K2AAM/HF-Receive-Multicoupler-/hardware/kicad/enclosure_report.txt

HAMMOND 1590C FIT - build A prototype (generated by enclosure.py)
Box frame: origin = centre of the four cover-screw holes; +y = front (output) wall; +x = U1 side; z = above INSIDE floor;
z_out = z + 2.25 = above the OUTSIDE bottom face.

1. Enclosure data and sources
   [MFR   ] outside length (at rim): 119.5
   [MFR   ] outside width (at rim): 94.0
   [MFR   ] body height without lid: 52.5
   [MFR   ] lid thickness: 4.0
   [MFR   ] overall height with lid: 56.5
   [MFR   ] floor thickness: 2.25
   [MFR   ] inside height, floor to underside of lid: 52.25  (lid pocket 2.00 deep (MFR))
   [CALC  ] inside floor to rim: 50.25
   [DWG   ] inside floor to bottom of lid lip: 48.25  (lid lip projects 2.0 below the rim, 0.57 mm inside the wall)
   [MFR   ] inside length at rim: 115.14
   [MFR   ] inside width at rim: 89.64
   [MFR   ] inside length near floor: 111.27  (DWG: measured 0.96 mm above the floor, at the top of the R1.0 floor fillet)
   [MFR   ] inside width near floor: 85.77
   [DWG   ] height of the near-floor inside dimensions: 0.96
   [DWG   ] inside floor fillet radius: 1.0
   [DWG   ] wall thickness (horizontal): 2.18  (outer wall drafted parallel to inner; 2.18 at the rim)
   [CALC  ] wall draft tan: 0.0393
   [MFR   ] cover-screw (6-32) pattern: (109.5, 84.0)  (screw centres (+-54.75, +-42.00): use as the drilling datum)
   [DWG   ] screw-pillar arc centre: (54.82, 42.07)
   [DWG   ] screw-pillar radius, worst (near floor): 5.94  (arcs R4.94 and R5.94 about the pillar centre; 103.64 x 78.14 between pillar faces at the rim (MFR))
   [CALC  ] draft: 2.25 deg per side

2. Stack-up (z above inside floor)
   M3 x 6 mm brass spacers -> PCB 6.0-7.6; BNC centreline 16.2; lid lip bottom 48.25; rim 50.25; lid pocket 52.25
   C1    top  26.7  ->  21.5 mm below the lid lip,  25.5 below the lid pocket (KEMET R60EI4470AA30J H 19.1)
   J5    top  24.0  ->  24.2 mm below the lid lip,  28.2 below the lid pocket (031-5431-10RFX CL 8.6 + 15.6/2)
   J2    top  24.0  ->  24.2 mm below the lid lip,  28.2 below the lid pocket (031-5431-10RFX CL 8.6 + 15.6/2)
   J4    top  24.0  ->  24.2 mm below the lid lip,  28.2 below the lid pocket (031-5431-10RFX CL 8.6 + 15.6/2)
   J3    top  24.0  ->  24.2 mm below the lid lip,  28.2 below the lid pocket (031-5431-10RFX CL 8.6 + 15.6/2)
   C22   top  20.6  ->  27.6 mm below the lid lip,  31.6 below the lid pocket (Panasonic FR 8x11.5 + 1.5)
   Solder side: 6.0 mm from PCB bottom to inside floor (clipped leads <= 1.5 mm -> >= 4.5 mm clear)

3. Board in the box
   Board 104 x 78, corner notches 7.0 x 7.0, outline unchanged. Board offset DY = +1.42 mm toward the front wall (set by the BNC faces).
   Side clearance at PCB bottom: x 3.83 each side; front edge 2.67; back edge 5.50
   screw pillar at (-54.82,-42.07) R5.94: clearance to notched board edge 4.86 mm
   screw pillar at (-54.82,+42.07) R5.94: clearance to notched board edge 3.16 mm
   screw pillar at (+54.82,-42.07) R5.94: clearance to notched board edge 4.86 mm
   screw pillar at (+54.82,+42.07) R5.94: clearance to notched board edge 3.16 mm
   Without the notches the board corner would be inside the pillars -> keep the notched outline.

4. Output BNCs (031-5431-10RFX, rear mount) on the drafted front wall
   The wall leans out 2.25 deg; across the 15.6 mm housing face that is 0.61 mm, so the face cannot seat flat on the as-cast wall.
   Inside: mill one flat strip 82 long x 22 high centred on the BNC row, plane perpendicular to the floor at y = 43.915
   (cut 0 at its top edge, 0.86 at its bottom edge). Separate dia 22 spot-faces would overlap at the 20 mm pitch.
   Outside: parallel strip 80 x 20 at y = 45.271 (cut 0.79 at its top edge, 0 at its bottom).
   Finished wall at each BNC: 1.36 mm (connector limit 5.0 max).
   BNC front face lands on the inside spot-face at board offset DY = +1.415: zero gap by construction; floor holes dia 4.2
   give +-0.6 mm float so the BNC nuts, not the spacers, position the board (tighten spacer screws last).

5. Insertion path of the board with its four BNCs (2D search over tilt and travel along the BNC axis)
   Back edge to back wall when level: 5.50 mm, but the 1/2-28 thread is 8.9 mm long,
   so the board cannot be slid in level: it has to go in tilted, which needs a front hole larger than the thread.
   opening 12.83 high: no path - the board cannot be fitted
   opening 14.00 high: no path - the board cannot be fitted
   opening 14.40 high: PATH FOUND (barrels fully withdrawn at a tilt of 29.5 deg, BNC end down)
   opening 15.50 high: PATH FOUND (barrels fully withdrawn at a tilt of 29.5 deg, BNC end down)
   Path found: back the board off level about 0.2 mm, then tilt the BNC end down while withdrawing;
   up to 31.0 deg while the thread is still in the slot, 31.0 deg once only the bayonet is (back end above the rim).
   Assembly is the same path in reverse (lid off).
   Chosen: vertical slot 12.9 wide x 15.5 high (obround, no D-flat; the soldered board stops the connectors turning).
   Amphenol's dia 12.83 D-hole is too tight for the tilt: with it the board cannot be fitted at all.
   Housing-face bearing on the inside spot-face: 62 mm2 (0.80 mm strips at the sides + corners).
   Outside: DIN 433 M12 flat washer (OD 20) + the supplied lock washer + nut; stack 4.4 mm of the 8.9 mm thread before the nut.
   Fit J1 and J6 (wired panel jacks) after the board: the tilting board sweeps through their volume.

6. Panel jacks
   J1 031-221-RFX, left wall: y = -8.0, z = 24.0 (z_out 26.25). Nut/body keep-out 15 deep, +-7.4:
      parts below: MH1; clearance below 7.0 mm, to lid lip 16.9 mm; wall 2.18 <= 3.2 max
   J6 Switchcraft 722A, back wall: x = +36.0, z = 26.0 (z_out 28.25). Body keep-out 16 deep, +-8 x +-6:
      parts below: C17, J6; clearance below 5.0 mm, to lid lip 16.2 mm; wall 2.18 <= 3.1 max
   Both are wired jacks, so the 2.25 deg wall draft only tilts the jack; no PCB load. Spot-face if a flat nut seat is wanted.

7. U1 (LM317T lying tab-down, tab = VOUT ~9.8 V)
   Tab/body x 30.3..51.2: 4.69 mm from the grounded right wall; top at z 12.6, 35.6 mm below the lid lip.
   No F.Cu copper under body/tab (keep-out on the PCB); tab rests on solder mask over bare laminate. Use a nylon M3 screw or none.

8. Screws and ground bond
   Spacers: Wurth 970060354, M3 x 6 brass female-female, 5 mm hex. Top: M3 x 5 pan + washer (2.9 mm engagement).
   Bottom: M3 x 5 pan + washer through dia 4.2 floor holes (2.25 mm engagement); 5.15 mm total < 6 mm spacer thread.
   Ground: spacer end faces bear on bare die-cast floor (natural 1590C; remove paint on a 1590CBK); BNC shells clamp to the
   bare spot-faces. MH1 sits 6.7 mm from the GDT ground pad.

9. Floor holes (box frame, from the cover-screw centre), dia 4.2: MH1 (-38.50, -10.58); MH2 (-46.50, +26.42); MH3 (+46.50, +26.42); MH4 (+47.50, -26.38); MH5 (-34.00, +11.42)
   Front-wall BNC slots: x = -30, -10, +10, +30; centre z = 16.20 (z_out 18.45); 12.9 wide x 15.5 high, axis parallel to the floor.
   Left-wall J1: y = -8.0, z_out 26.25; back-wall J6: x = +36.0, z_out 28.25.

RESULT OK (assumptions in section 1 and the ASSUME items in docs/pcb-prototype-A.md still need measuring)
