K2AAM/HF-Receive-Multicoupler-/hardware/kicad/drill_drawing_1590C.pdf

inside floor

20.00 | 20.00 | 20.00

30.00 from centre

Z_out 18.45

FRONT (OUTPUT) WALL - viewed from outside. 4 x SLOT 12.9 wide x 15.5 high (J2-J5, 031-5431-10RFX). 15.5

12.9

Mill flat, perpendicular to the slot axis: INSIDE strip 82 x 22 (blue dotted; cut 0 at its top edge -> 0.86 at its bottom) and OUTSIDE strip 80 x 20 (red dashed; 0 at its bottom -> 0.79 at its top). Finished wall between the strips 1.36 +-0.1. Slots: drill dia 12.9 at +-1.3 mm above/below centre and file to the obround.

DATUMS: X/Y = centre of the four 6-32 cover-screw holes (109.50 x 84.00 pattern, Hammond). Z_out = height above the OUTSIDE bottom face; the inside floor is at Z_out 2.25 (Hammond floor 2.25). Drill wall holes parallel to the floor
(2.25 deg off the drafted wall normal). Dimensions in mm. Verify on the actual box before drilling.

8.00 toward the back wall

Z_out 26.25

LEFT END WALL (input) - viewed from outside; front/output wall to the LEFT. J1 Amphenol 031-221-RFX.

D-hole dia 11.1 with flat 10.3 across (Amphenol panel type U) - confirm on the 031-221-RFX drawing. Connector inserted from outside; nut + lock washer inside.

DATUMS: X/Y = centre of the four 6-32 cover-screw holes (109.50 x 84.00 pattern, Hammond). Z_out = height above the OUTSIDE bottom face; the inside floor is at Z_out 2.25 (Hammond floor 2.25). Drill wall holes parallel to the floor
(2.25 deg off the drafted wall normal). Dimensions in mm. Verify on the actual box before drilling.

36.00 toward the U1 / right end

Z_out 28.25

BACK WALL (DC input) - viewed from outside; the U1 end is on the RIGHT. J6 Switchcraft 722A.

D-hole dia 8.00 with flat 7.37 across (Switchcraft 5/16-32 bushing) - confirm on the 722A drawing.
Jack body inside, washer + nut outside; turn the solder lugs horizontal.

DATUMS: X/Y = centre of the four 6-32 cover-screw holes (109.50 x 84.00 pattern, Hammond). Z_out = height above the OUTSIDE bottom face; the inside floor is at Z_out 2.25 (Hammond floor 2.25). Drill wall holes parallel to the floor
(2.25 deg off the drafted wall normal). Dimensions in mm. Verify on the actual box before drilling.

MH1
(-38.50, -10.58)

MH2
(-46.50, +26.42)

MH3
(+46.50, +26.42)

MH4
(+47.50, -26.38)

MH5
(-34.00, +11.42)

FLOOR - viewed from INSIDE (output wall at the top). 5 x dia 4.2 for M3 spacer screws.

Coordinates (x, y) from the centre of the cover-screw pattern; + y toward the output wall, + x toward the U1 end.
When marking from the OUTSIDE (box upside down) the x values change sign. Dashed green = PCB outline.

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
