K2AAM/HF-Receive-Multicoupler-/hardware/kicad/erc_native.png

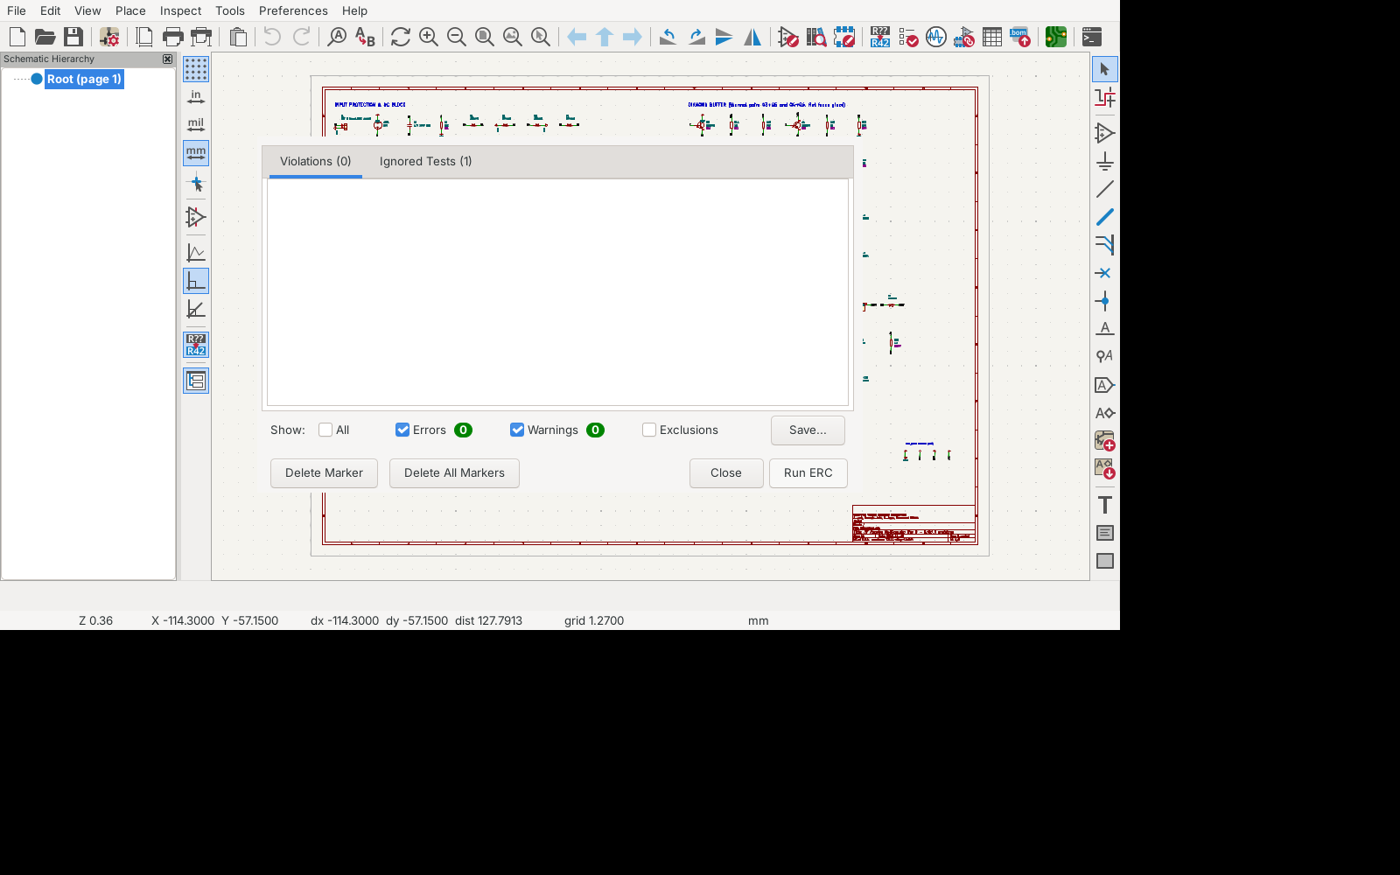
hardware/kicad/erc_native.png
