K2AAM/HF-Receive-Multicoupler-/hardware/kicad/img/drill_back_wall.png

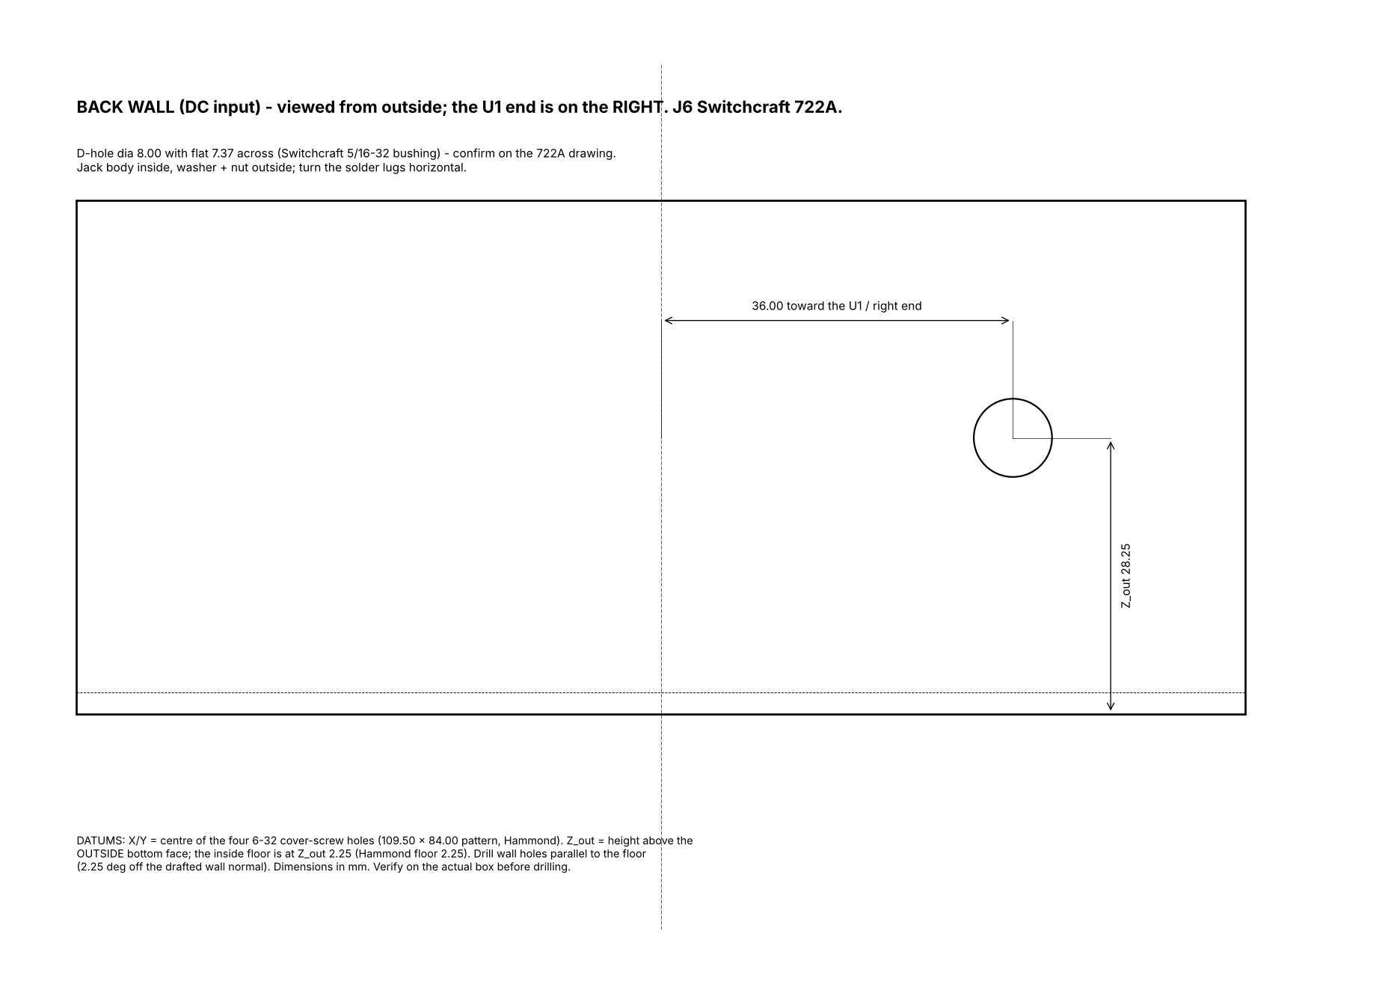
hardware/kicad/img/drill_back_wall.png
