K2AAM/HF-Receive-Multicoupler-/hardware/kicad/img/drill_floor.png

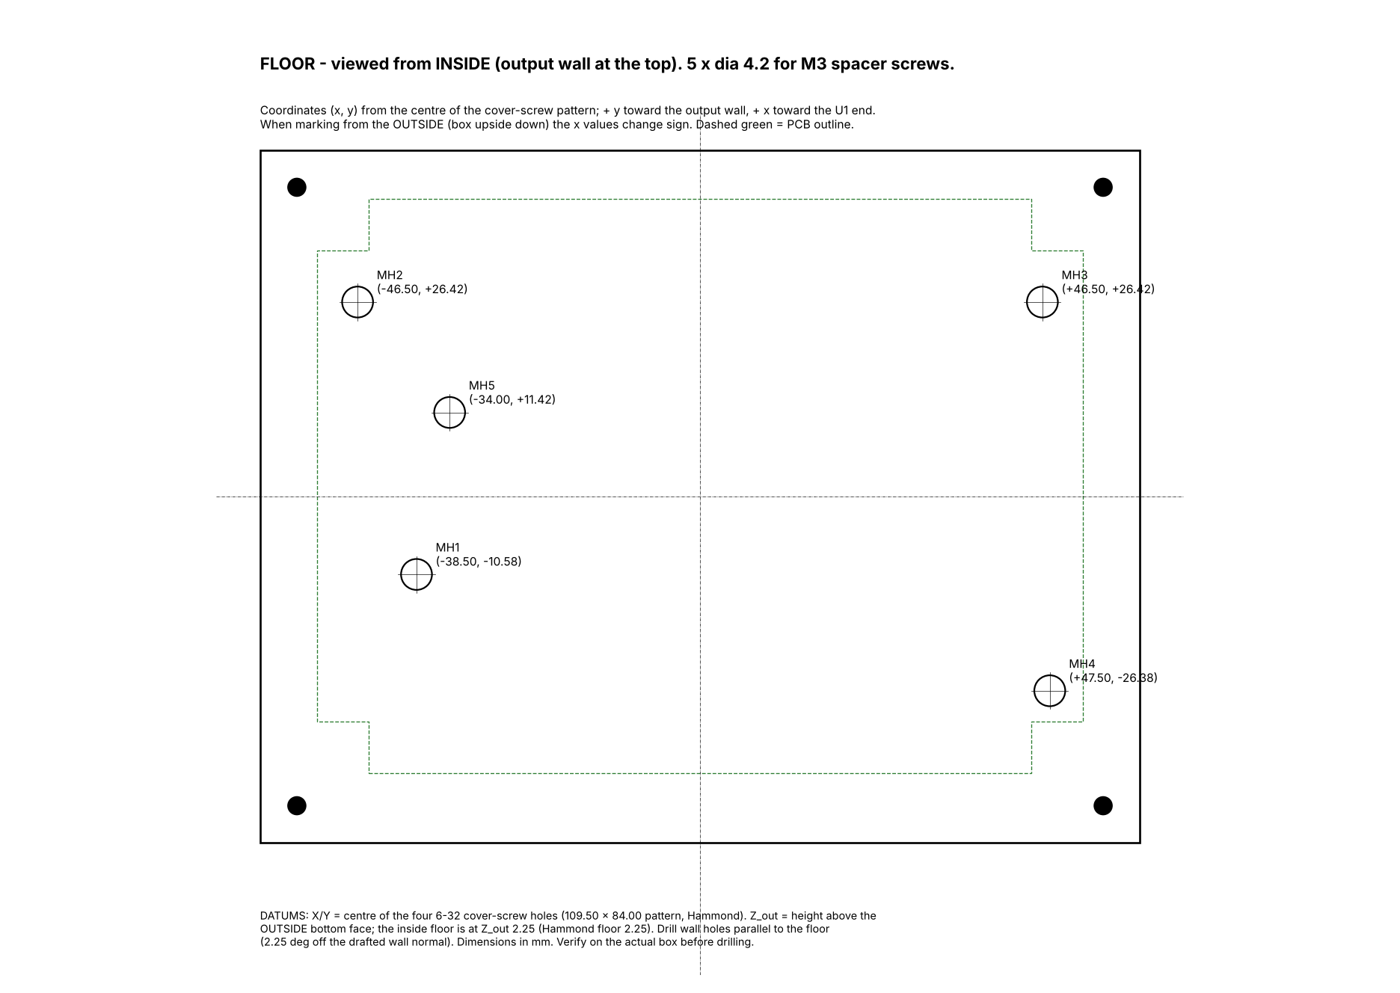
hardware/kicad/img/drill_floor.png
