K2AAM/HF-Receive-Multicoupler-/hardware/kicad/img/drill_front_wall.png

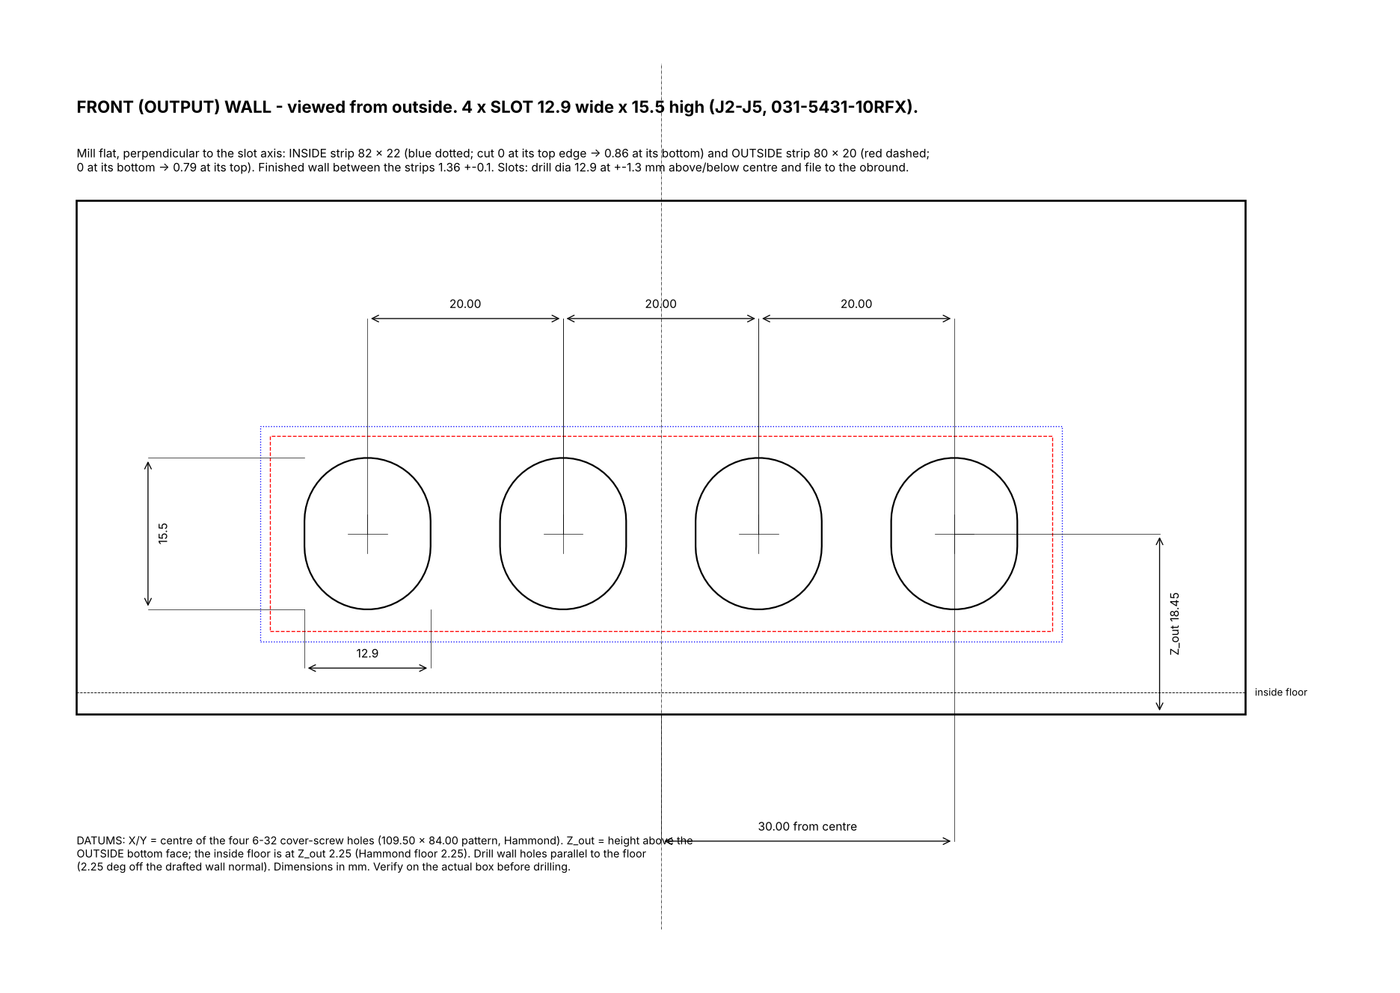
hardware/kicad/img/drill_front_wall.png
