K2AAM/HF-Receive-Multicoupler-/hardware/kicad/img/drill_left_wall.png

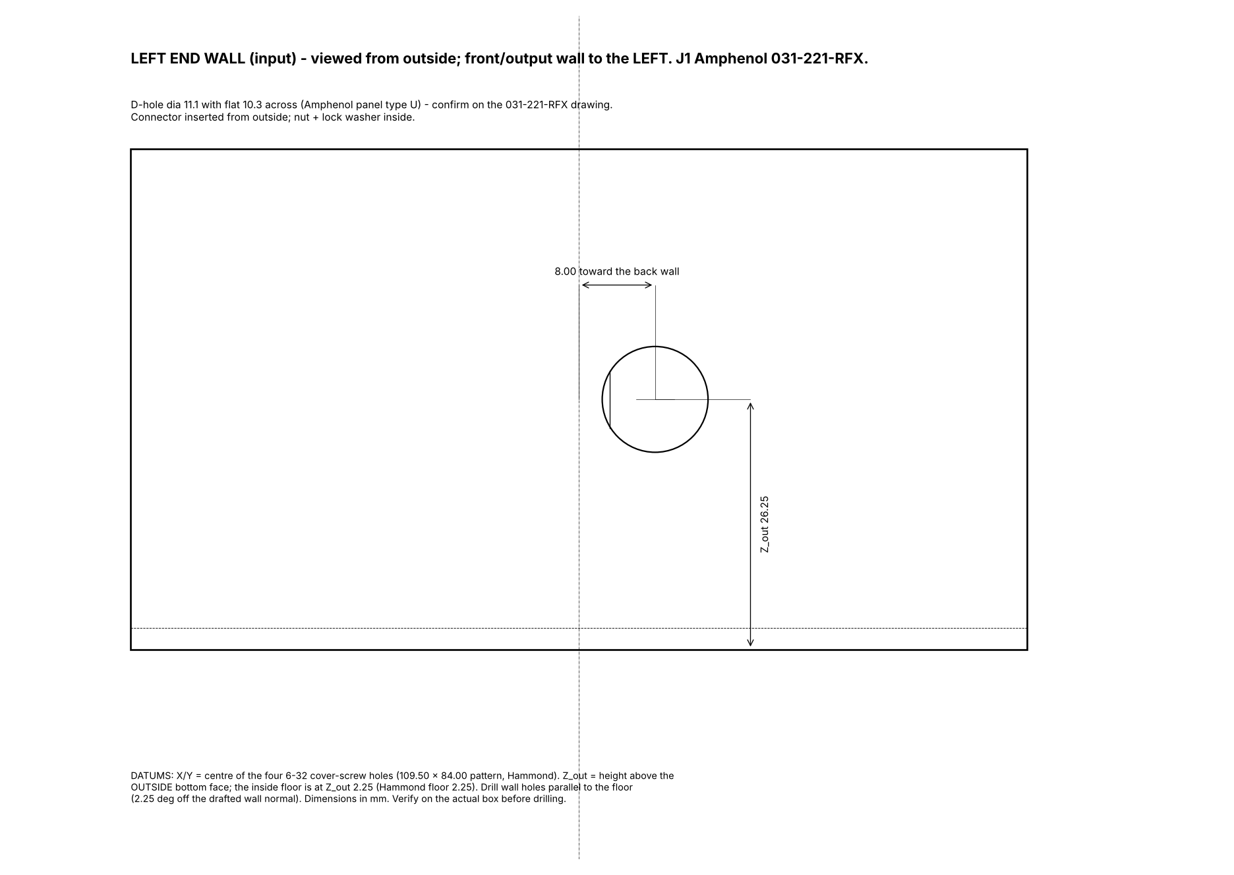
hardware/kicad/img/drill_left_wall.png
