K2AAM/HF-Receive-Multicoupler-/hardware/kicad/img/enclosure_3d_b.png

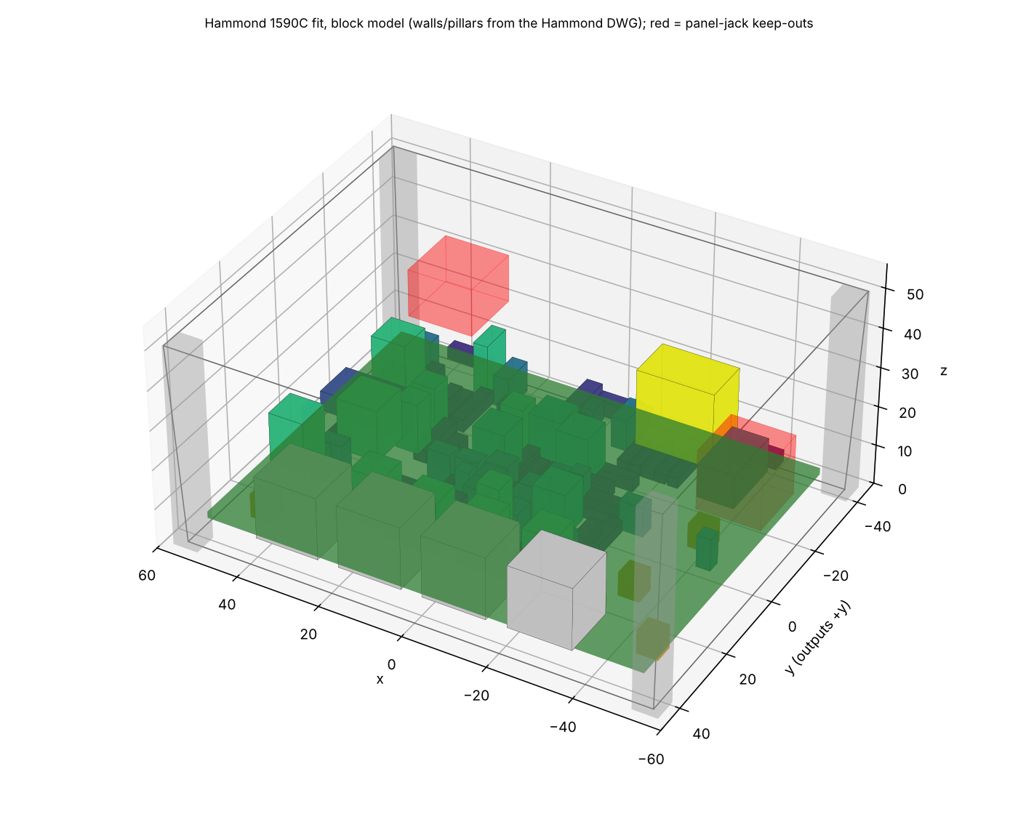
hardware/kicad/img/enclosure_3d_b.png
