K2AAM/HF-Receive-Multicoupler-/hardware/kicad/img/enclosure_insertion.png

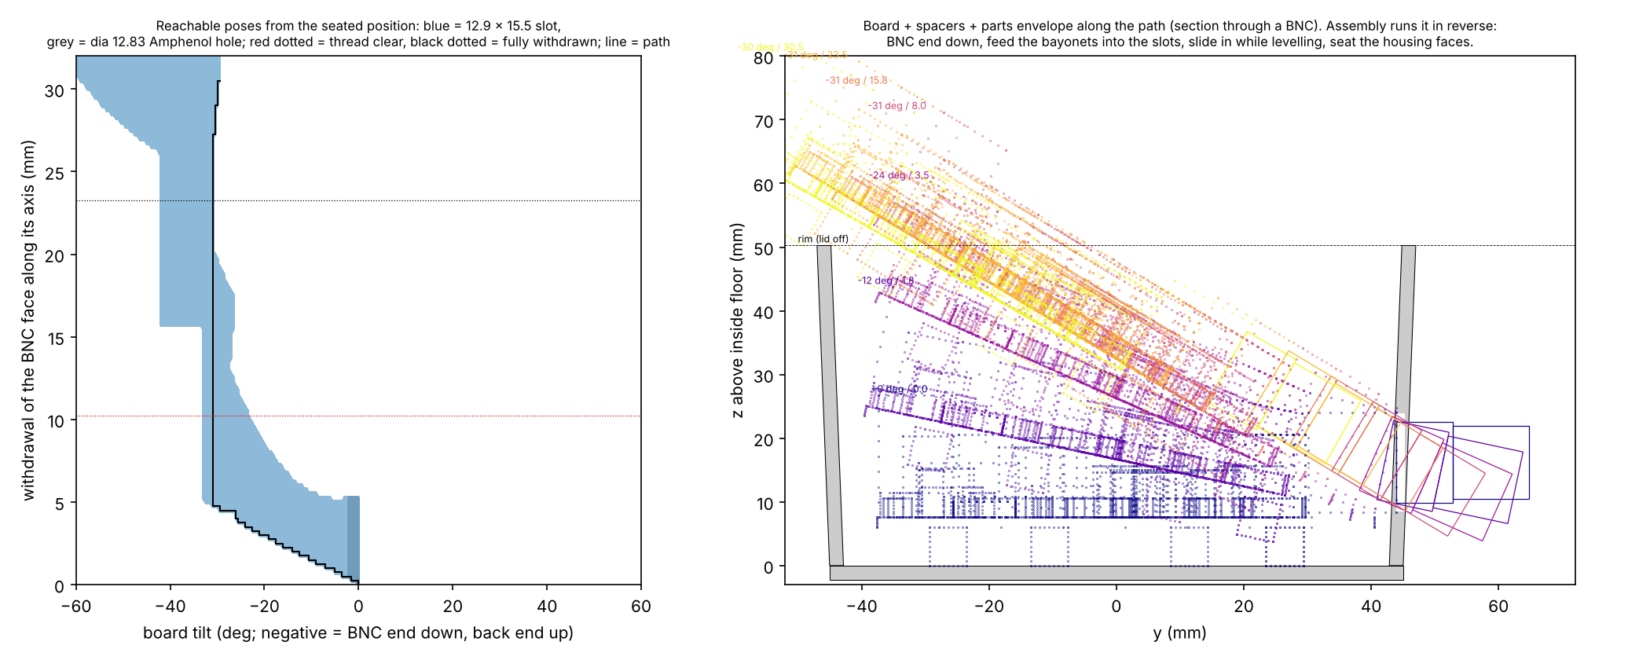
hardware/kicad/img/enclosure_insertion.png
