K2AAM/HF-Receive-Multicoupler-/hardware/kicad/img/enclosure_side.png

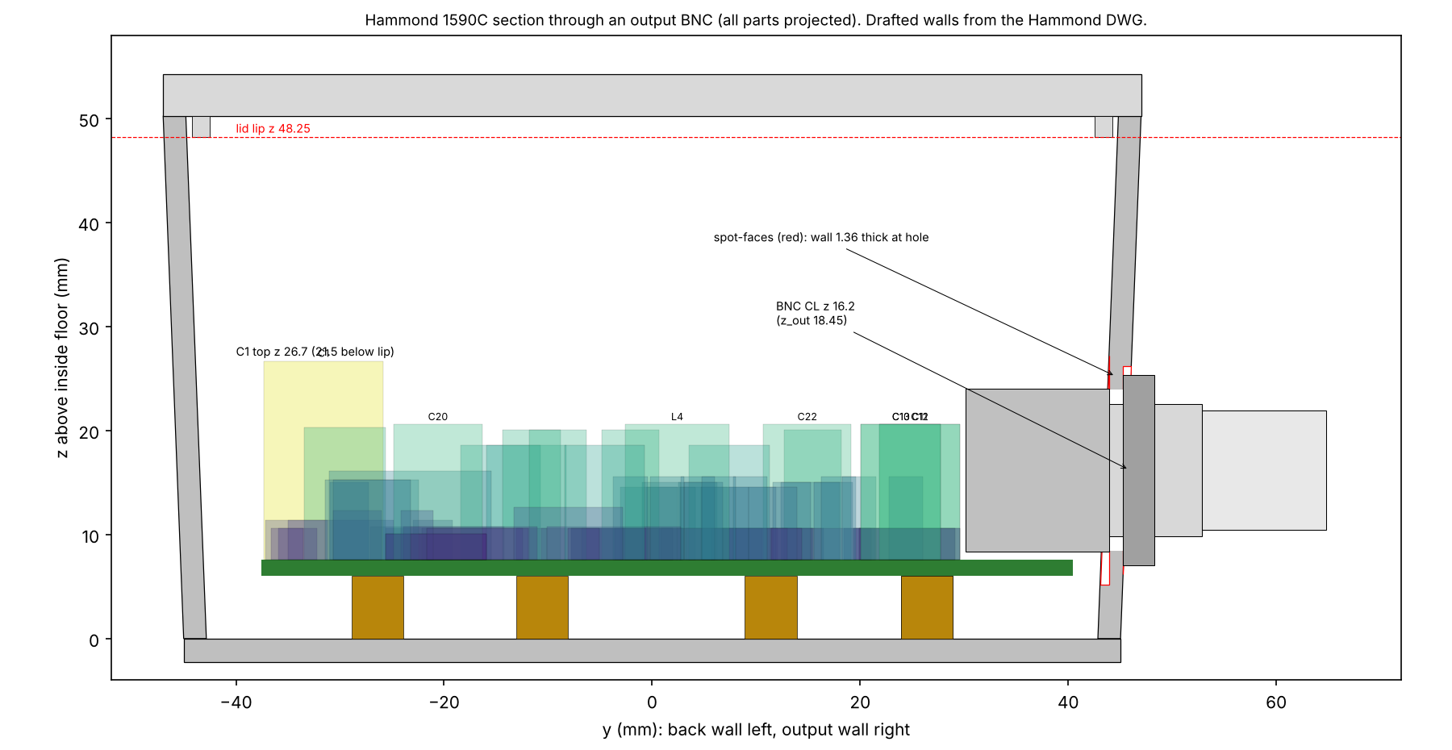
hardware/kicad/img/enclosure_side.png
