K2AAM/HF-Receive-Multicoupler-/hardware/kicad/img/enclosure_top.png

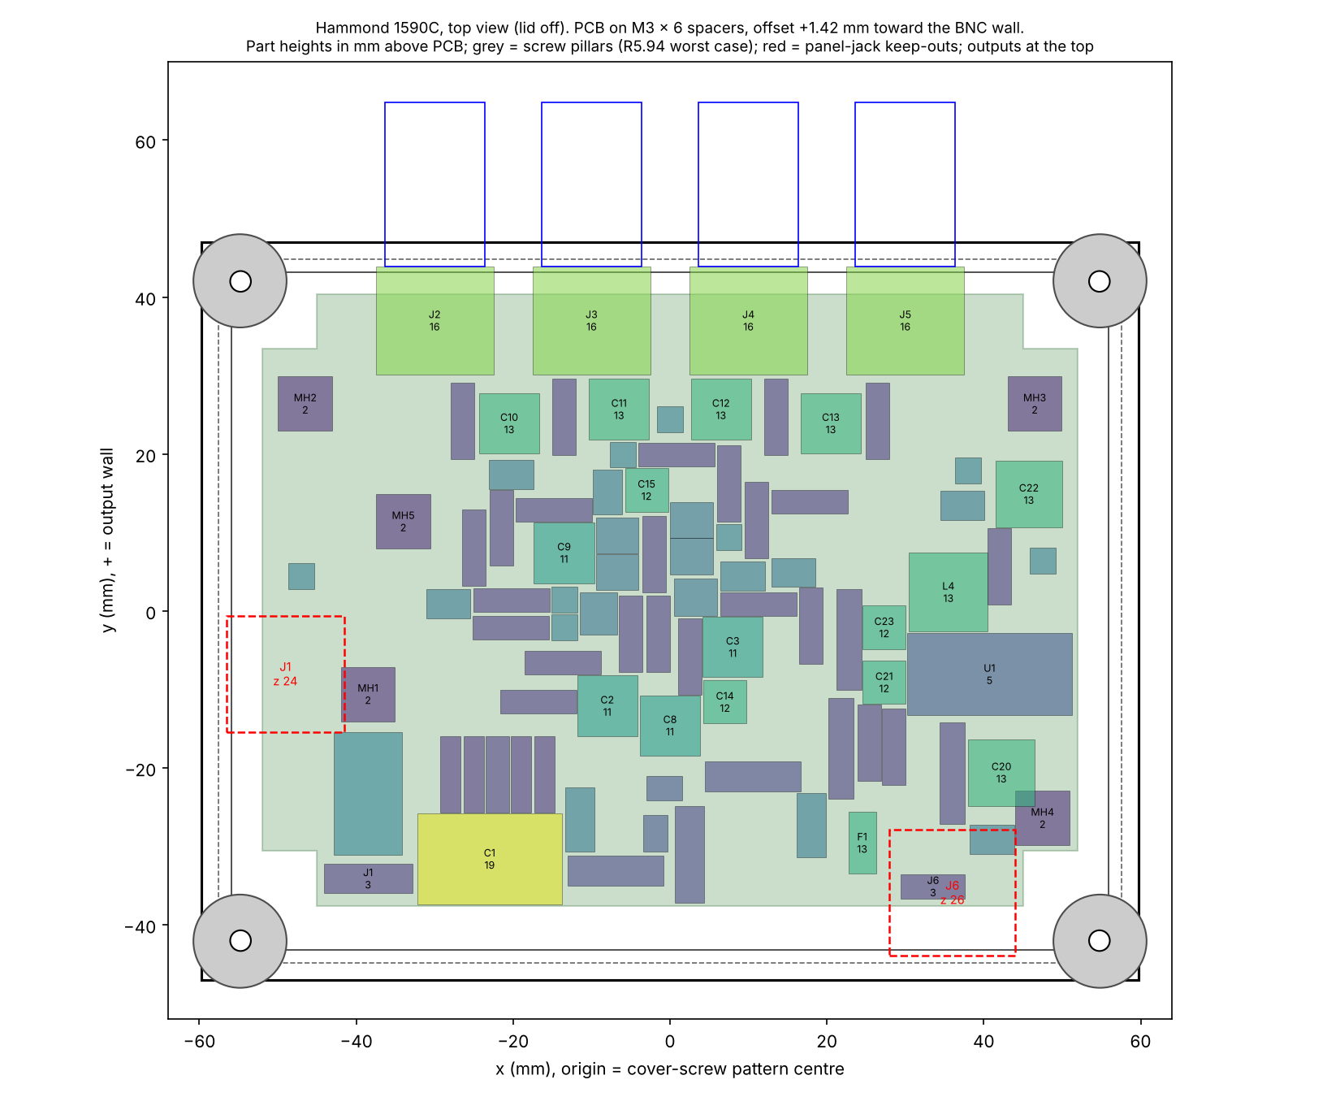
hardware/kicad/img/enclosure_top.png
