K2AAM/HF-Receive-Multicoupler-/hardware/kicad/img/pcb_back.png

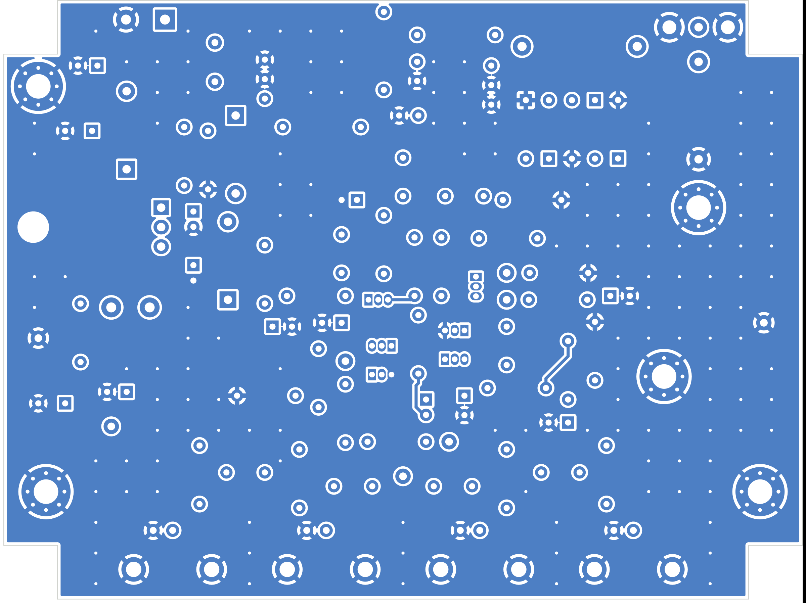
hardware/kicad/img/pcb_back.png
