K2AAM/HF-Receive-Multicoupler-/hardware/kicad/img/pcb_both_layers.png

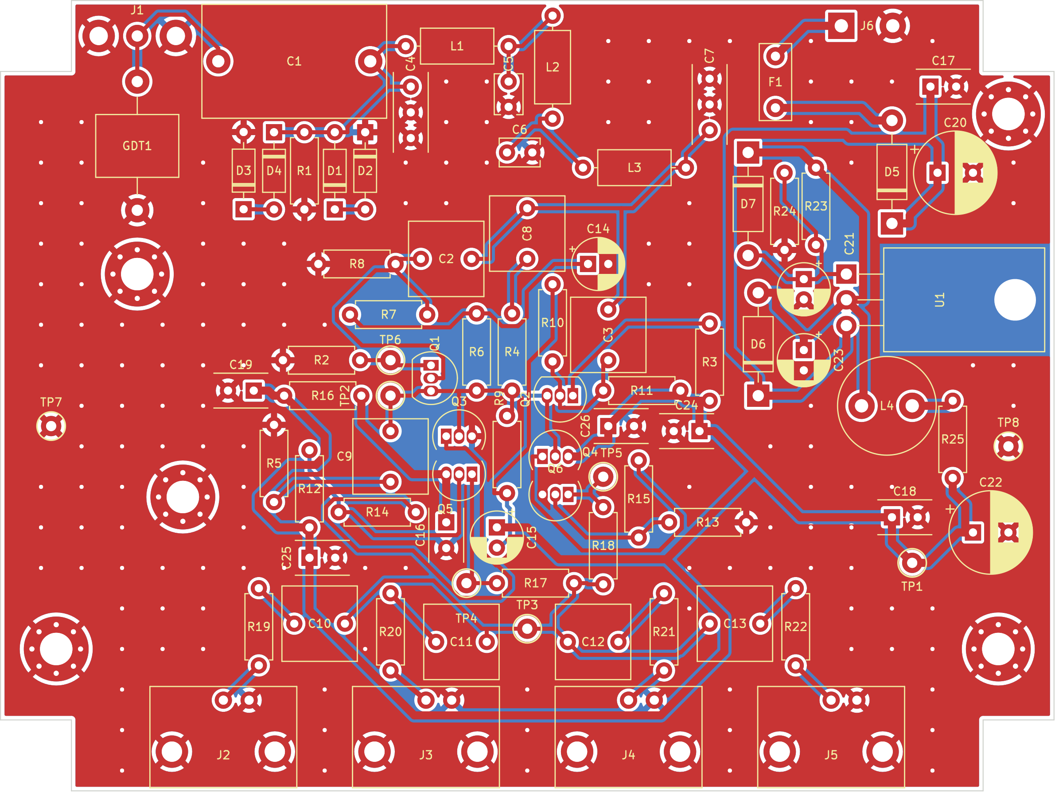
hardware/kicad/img/pcb_both_layers.png
