K2AAM/HF-Receive-Multicoupler-/hardware/kicad/img/pcb_assembly.png

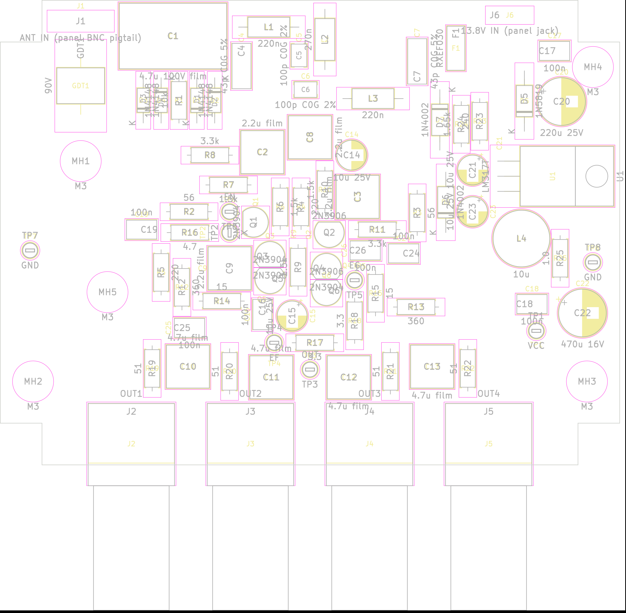
hardware/kicad/img/pcb_assembly.png
