K2AAM/HF-Receive-Multicoupler-/sim/results/ac_A.csv

f_Hz | S21_dB | S11_dB | S22_dB | port2_to_port3_dB | port2_to_input_dB
1.000000000000000000e+03 | 1.320148060580553562e+00 | -8.736999214483466503e+00 | -1.006861487812768452e+01 | -3.507588981349814361e+01 | -1.101485008985155787e+02
1.059265580000000000e+03 | 1.361577099307021088e+00 | -9.167336521910572245e+00 | -1.051792742521947055e+01 | -3.498657851272088237e+01 | -1.100533167309908009e+02
1.122043560000000070e+03 | 1.398978549487476242e+00 | -9.603441901930365177e+00 | -1.097136304534435070e+01 | -3.490619560828077539e+01 | -1.099673853878414320e+02
1.188542120000000068e+03 | 1.432703397054975625e+00 | -1.004474006290693389e+01 | -1.142843767516014530e+01 | -3.483391989248638509e+01 | -1.098899036904376345e+02
1.258981749999999920e+03 | 1.463079424205812940e+00 | -1.049067756510958915e+01 | -1.188869096774181955e+01 | -3.476899169636543974e+01 | -1.098201200607393275e+02
1.333596029999999928e+03 | 1.490411320964367015e+00 | -1.094072258379615548e+01 | -1.235168529018250183e+01 | -3.471071128410732598e+01 | -1.097573347799722114e+02
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
