K2AAM/HF-Receive-Multicoupler-/sim/results/ac_B.csv

f_Hz | S21_dB | S11_dB | S22_dB | port2_to_port3_dB | port2_to_input_dB
1.000000000000000000e+03 | 2.666041588387691341e+00 | -9.103276855360697084e+00 | -1.006862275483740632e+01 | -3.507545638599228965e+01 | -1.106223841723725201e+02
1.059265580000000000e+03 | 2.716643779757672128e+00 | -9.521847122942089570e+00 | -1.051793515142616897e+01 | -3.498614440194367603e+01 | -1.105374740349650438e+02
1.122043560000000070e+03 | 2.762270298438290084e+00 | -9.942667470255766915e+00 | -1.097137051366948768e+01 | -3.490576097157960334e+01 | -1.104610055914254758e+02
1.188542120000000068e+03 | 2.803362826709868472e+00 | -1.036493367214451133e+01 | -1.142844493919783133e+01 | -3.483348470017982379e+01 | -1.103922115912158688e+02
1.258981749999999920e+03 | 2.840332987807440812e+00 | -1.078784421129119586e+01 | -1.188869799152961448e+01 | -3.476855602970280046e+01 | -1.103303804783160444e+02
1.333596029999999928e+03 | 2.873562574511130396e+00 | -1.121059919029893592e+01 | -1.235169180502078845e+01 | -3.471027526925103501e+01 | -1.102748552716737862e+02
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
