K2AAM/HF-Receive-Multicoupler-/sim/results/ac_C.csv

f_Hz | S21_dB | S11_dB | S22_dB | port2_to_port3_dB | port2_to_input_dB
1.000000000000000000e+03 | 4.956582105674335992e+00 | -9.385034642665159410e+00 | -1.006863279817944168e+01 | -3.507527872839128236e+01 | -1.117700565853000683e+02
1.059265580000000000e+03 | 5.015234768755306938e+00 | -9.815168399603543037e+00 | -1.051794516267602297e+01 | -3.498596518256936605e+01 | -1.116903543568638071e+02
1.122043560000000070e+03 | 5.068014684606202636e+00 | -1.024743504124890059e+01 | -1.097138058546183004e+01 | -3.490558028818536940e+01 | -1.116187048970587057e+02
1.188542120000000068e+03 | 5.115461773411842827e+00 | -1.068109911592069317e+01 | -1.142845487102379387e+01 | -3.483330281560692754e+01 | -1.115543527026205339e+02
1.258981749999999920e+03 | 5.158076053805935146e+00 | -1.111543320521503908e+01 | -1.188870786583711237e+01 | -3.476837305361988228e+01 | -1.114966015424361103e+02
1.333596029999999928e+03 | 5.196318558191680204e+00 | -1.154971506929411973e+01 | -1.235170158275927754e+01 | -3.471009131966146555e+01 | -1.114448121465132999e+02
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
