K2AAM/HF-Receive-Multicoupler-/sim/results/response.png

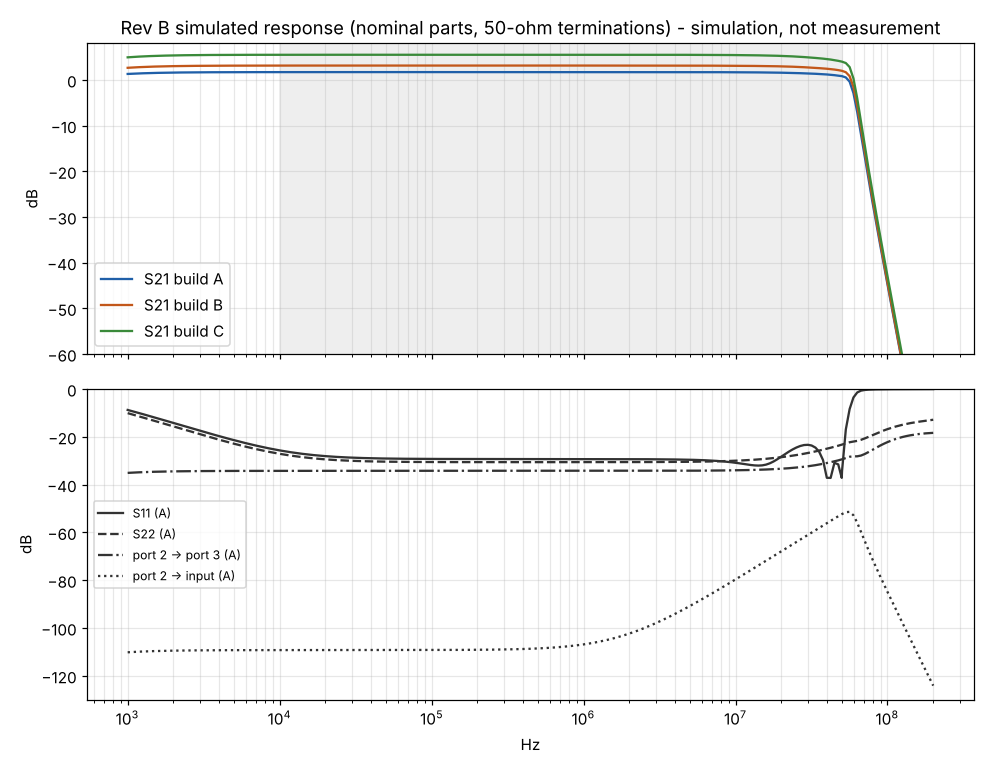
sim/results/response.png
