K2AAM/HF-Receive-Multicoupler-/hardware/kicad/hfmc_schematic.pdf

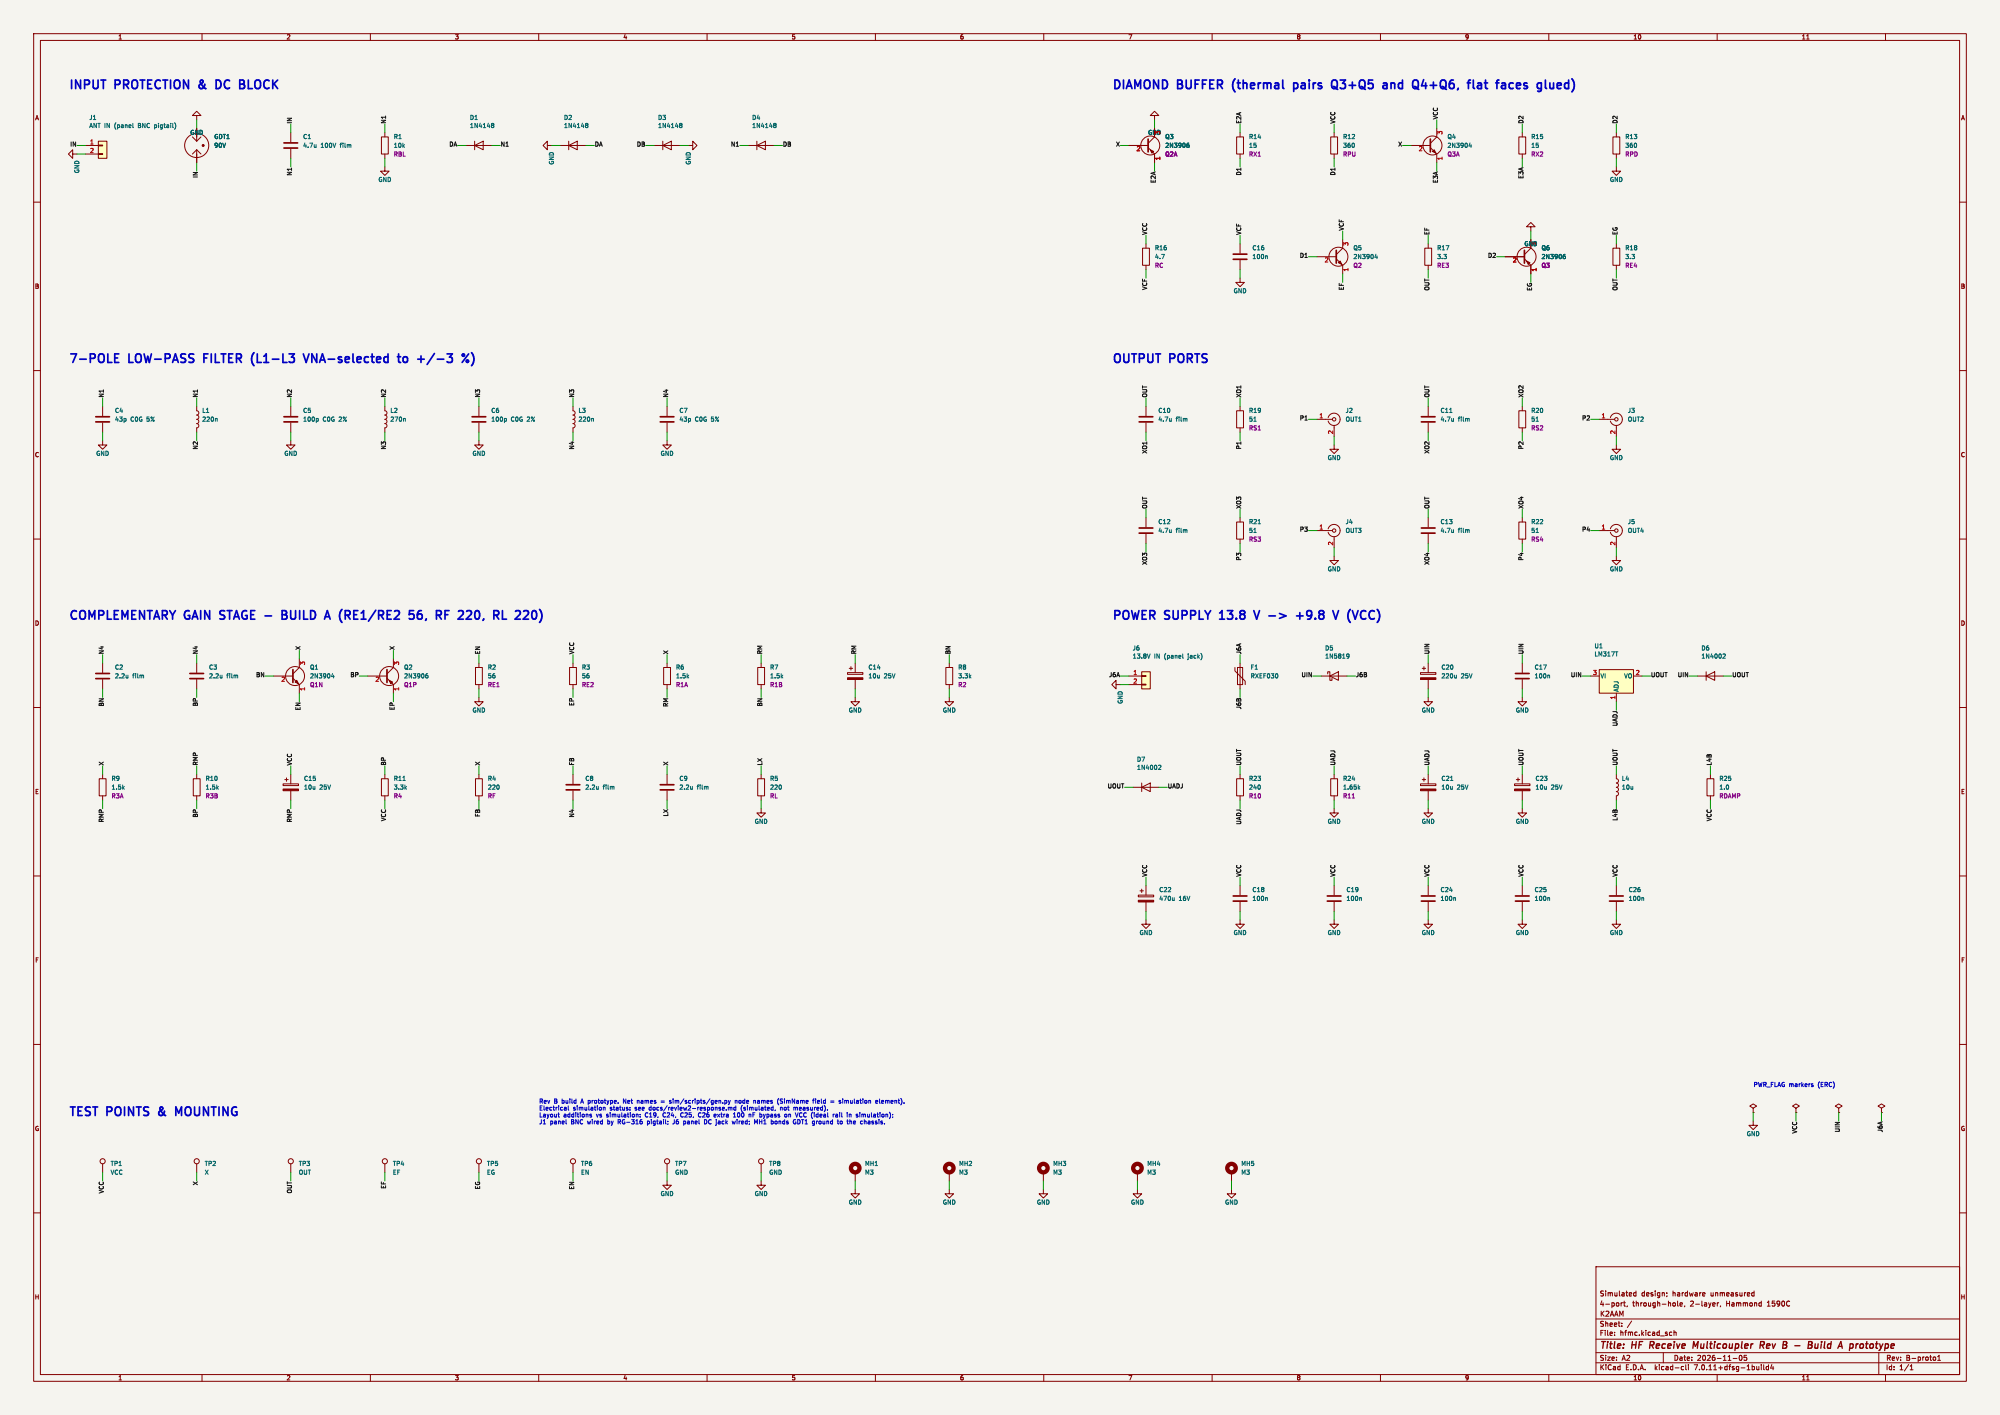
[picture p17: page 1]

INPUT PROTECTION & DC BLOCK

X N4 N4 RM BP LX VCC N4 BP N3 OUT BN FBLX N4
