K2AAM/HF-Receive-Multicoupler-/hardware/kicad/hfmc.kicad_pcb

## KiCad design hardware/kicad/hfmc.kicad_pcb (2026-11-06)

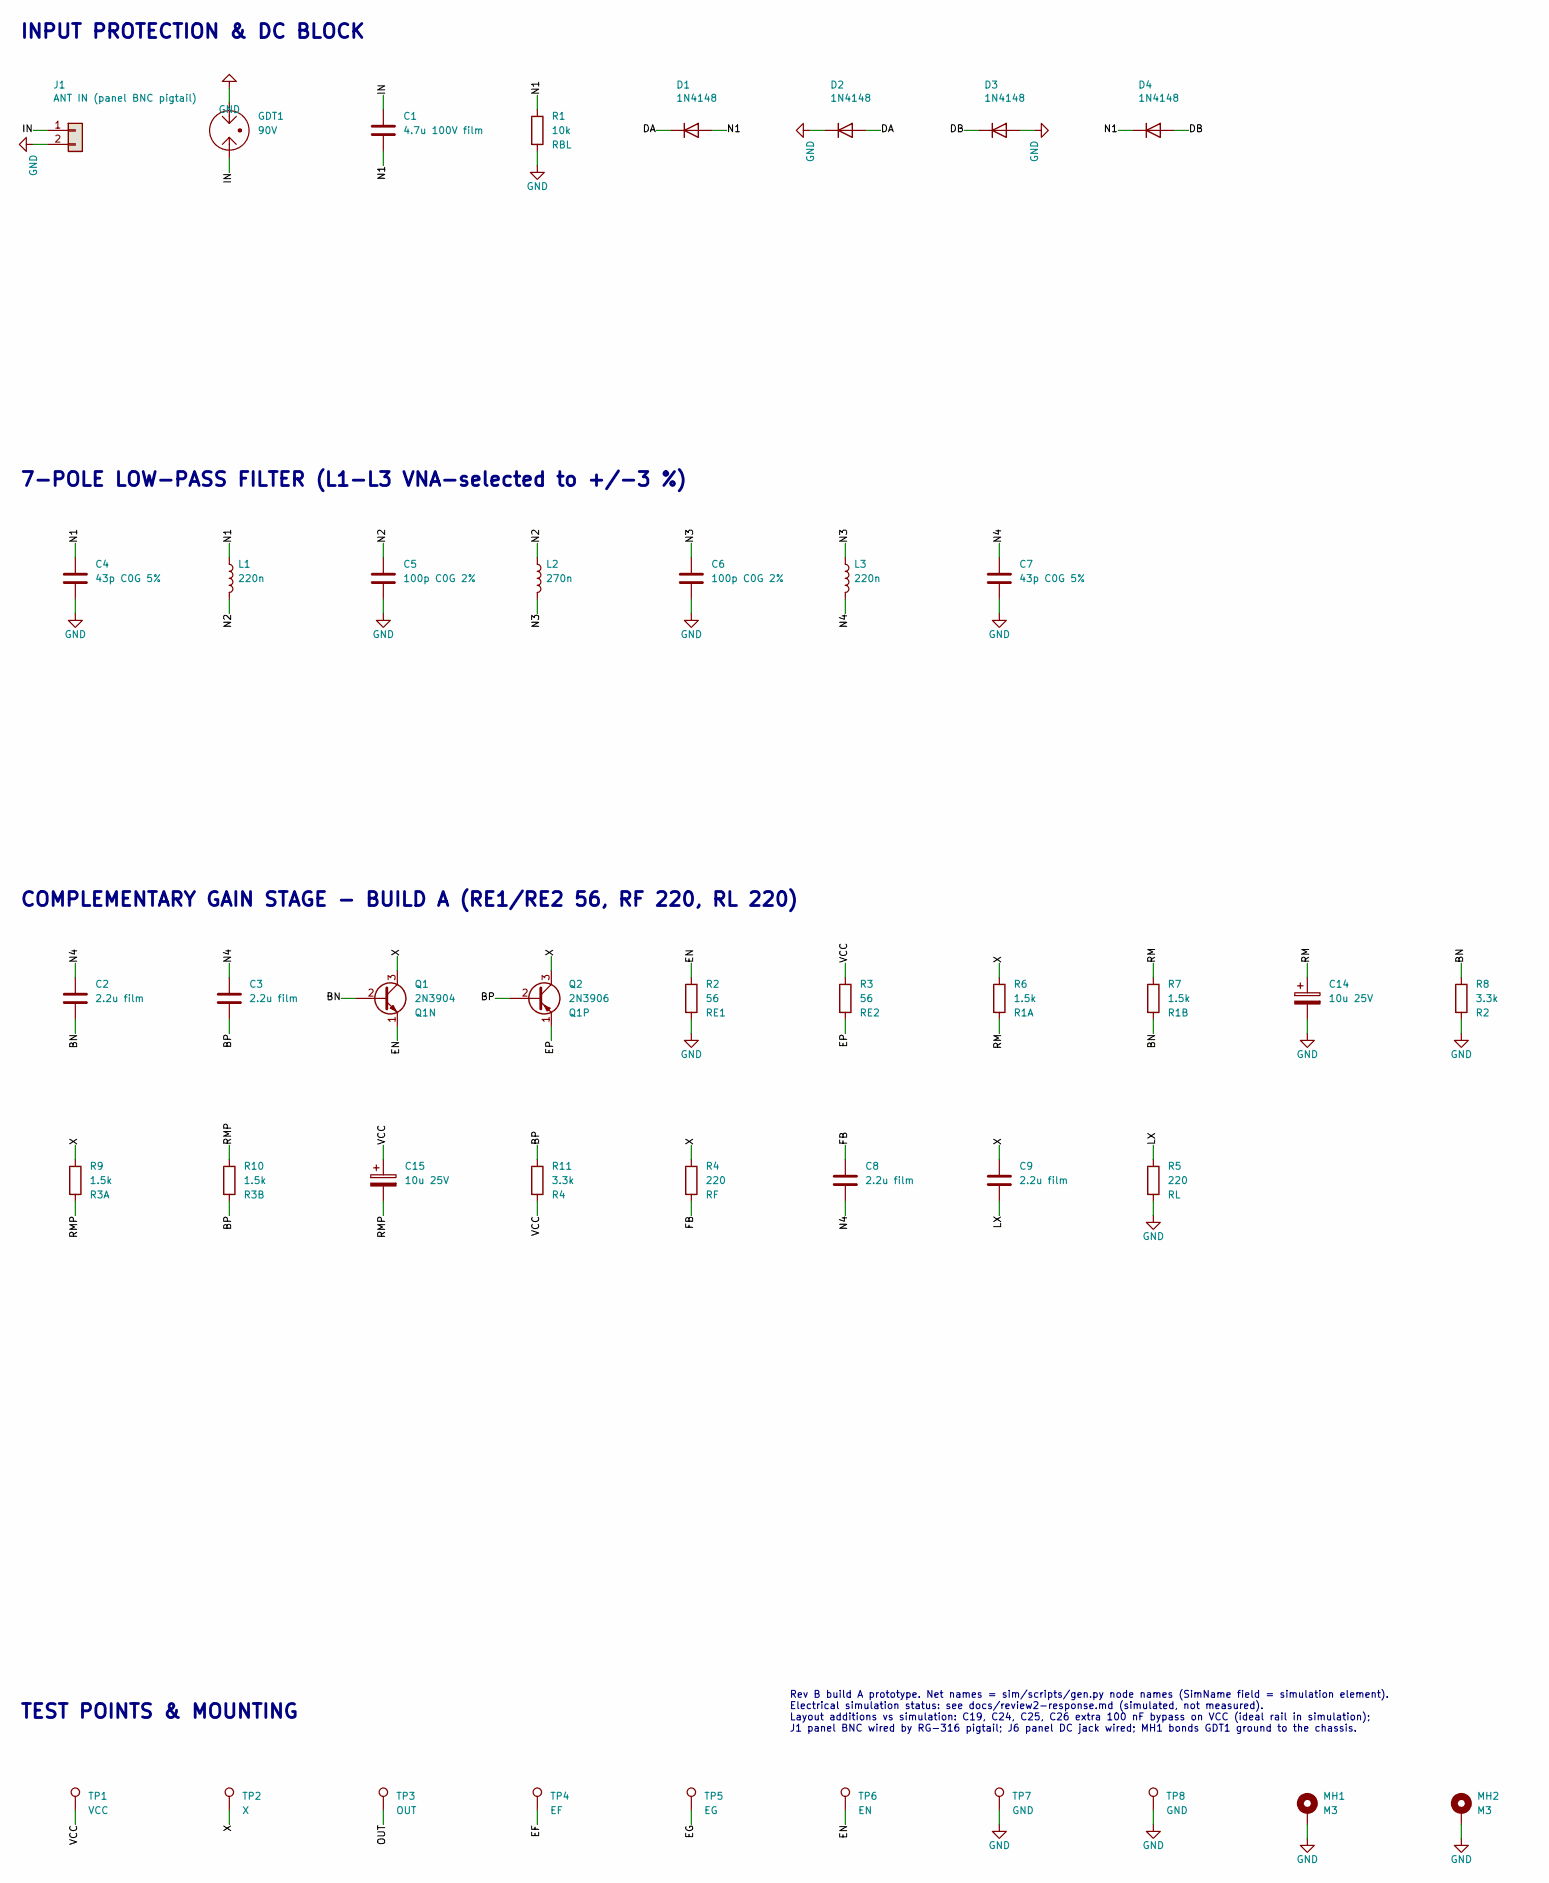
[picture p18: schematic hfmc.kicad_sch, HF Receive Multicoupler Rev B - Build A prototype, part in row 1, column 1]

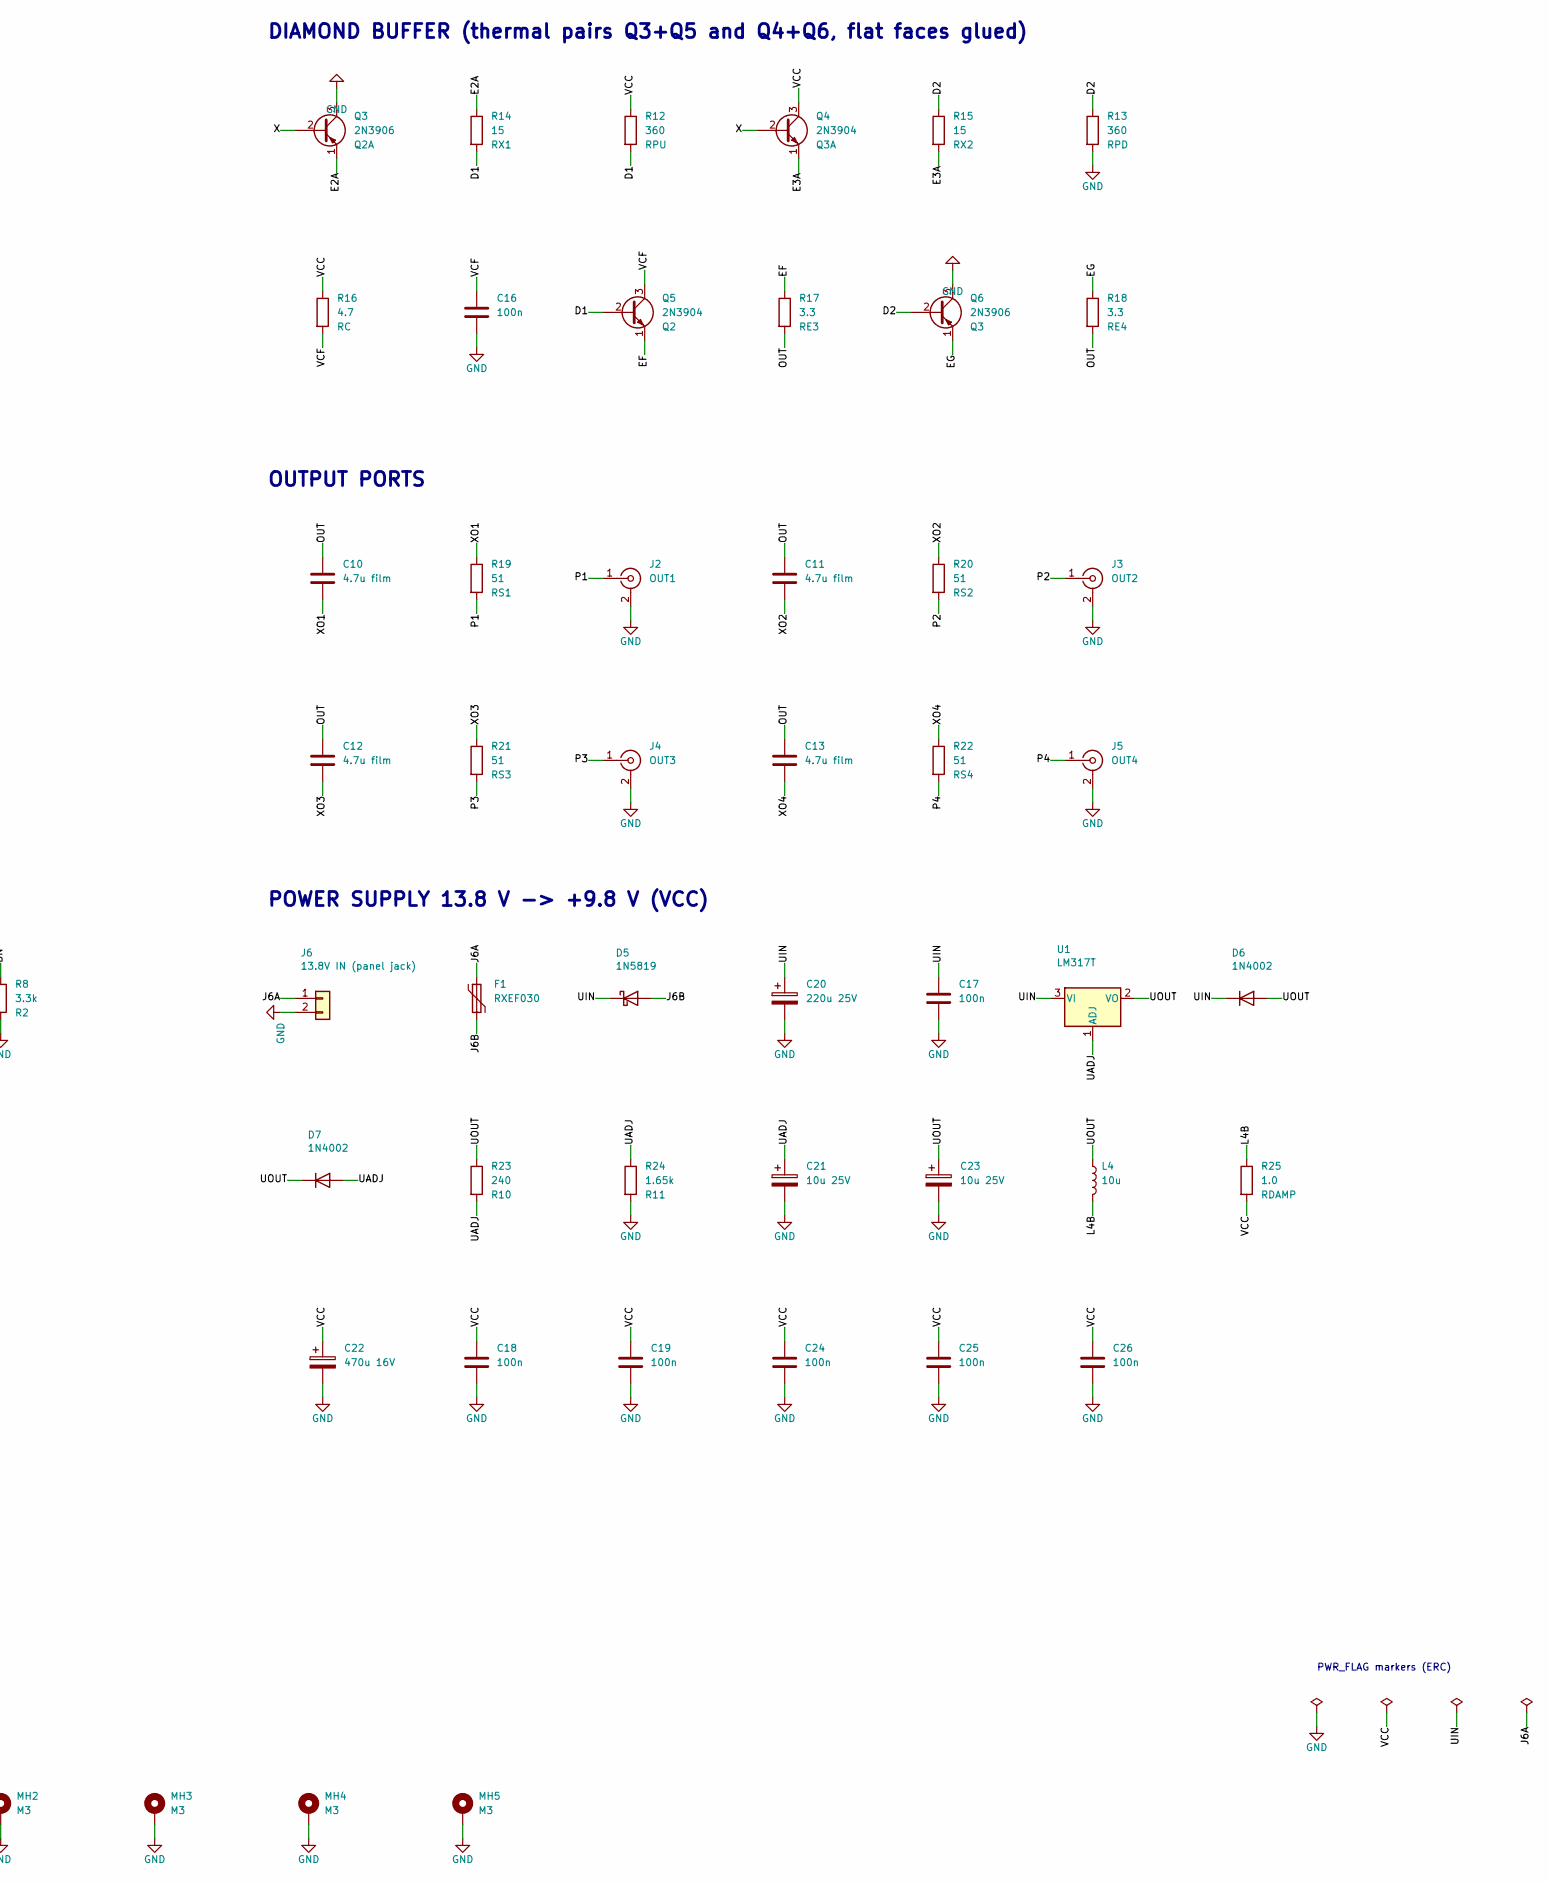
[picture p19: schematic hfmc.kicad_sch, HF Receive Multicoupler Rev B - Build A prototype, part in row 1, column 2]

Parts:
C1: 4.7u 100V film; C_Rect_L18.0mm_W11.0mm_P15.00mm_FKS3_FKP3; MPN KEMET R60EI4470AA30J
C2, C3, C8, C9: 2.2u film; C_Rect_L7.2mm_W7.2mm_P5.00mm_FKS2_FKP2_MKS2_MKP2; MPN KEMET R82CC4220DQ70J
C4, C7: 43p C0G 5%; C_Disc_W3.2mm_P2.54mm_P5.08mm_Universal; MPN KEMET C325C430JAG5TA
C5, C6: 100p C0G 2%; C_Disc_D3.8mm_W2.6mm_P2.50mm; MPN KEMET C315C101G1G5TA
C10, C11, C12, C13: 4.7u film; C_Rect_L7.2mm_W7.2mm_P5.00mm_FKS2_FKP2_MKS2_MKP2; MPN KEMET R82CC4470DQ30K
C14, C15, C21, C23: 10u 25V; CP_Radial_D5.0mm_P2.00mm; MPN Panasonic ECA-1EM100
C16, C17, C18, C19, C24, C25, C26: 100n; C_Radial_KEMET_C320_L5.08mm_T3.18mm_P2.54mm; MPN KEMET C320C104K5R5TA
C20: 220u 25V; CP_Radial_D8.0mm_P3.50mm; MPN Panasonic EEU-FR1E221
C22: 470u 16V; CP_Radial_D8.0mm_P3.50mm; MPN Panasonic EEU-FR1C471
D1, D2, D3, D4: 1N4148; D_DO-35_SOD27_P7.62mm_Horizontal; MPN onsemi 1N4148
D5: 1N5819; D_DO-41_SOD81_P10.16mm_Horizontal; MPN onsemi 1N5819
D6, D7: 1N4002; D_DO-41_SOD81_P10.16mm_Horizontal; MPN onsemi 1N4002
F1: RXEF030; Fuse_Littelfuse_RXEF_7.4x3.0mm_P5.10mm; MPN Littelfuse RXEF030
GDT1: 90V; GDT_Bourns_2027_Axial_D8.0mm_L6.0mm_P12.70mm_Horizontal; MPN Bourns 2027-09-BLF
J1: ANT IN (panel BNC pigtail); Pads_CoaxPigtail_RG316; MPN Amphenol RF 031-221-RFX (panel BNC, wir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
J2: OUT1; BNC_Amphenol_031-5431-10RFX_Horizontal; MPN Amphenol RF 031-5431-10RFX
J3: OUT2; BNC_Amphenol_031-5431-10RFX_Horizontal; MPN Amphenol RF 031-5431-10RFX
J4: OUT3; BNC_Amphenol_031-5431-10RFX_Horizontal; MPN Amphenol RF 031-5431-10RFX
J5: OUT4; BNC_Amphenol_031-5431-10RFX_Horizontal; MPN Amphenol RF 031-5431-10RFX
J6: 13.8V IN (panel jack); Pads_PowerWire_1x02_P5.08mm; MPN Switchcraft 722A (2.1 mm panel jack, ce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
L1, L3: 220n; L_Axial_L7.0mm_D3.3mm_P10.16mm_Horizontal_Fastron_MICC; MPN Bourns 78FR22K-RC (VNA-selected +/-3%)
L2: 270n; L_Axial_L7.0mm_D3.3mm_P10.16mm_Horizontal_Fastron_MICC; MPN Bourns 78FR27K-RC (VNA-selected +/-3%)
L4: 10u; L_Radial_D9.5mm_P5.00mm_Fastron_07HVP; MPN Bourns RLB0914-100KL
MH1, MH2, MH3, MH4, MH5: M3; MountingHole_3.2mm_M3_Pad_Via; MPN Wurth 970060354 (M3 x 6 mm brass hex sp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
Q1: 2N3904; TO-92_Inline; MPN onsemi 2N3904BU
Q2: 2N3906; TO-92_Inline; MPN onsemi 2N3906BU
Q3, Q6: 2N3906; TO-92_Inline_ThermalPair; MPN onsemi 2N3906BU
Q4, Q5: 2N3904; TO-92_Inline_ThermalPair; MPN onsemi 2N3904BU
R1: 10k; R_Axial_DIN0207_L6.3mm_D2.5mm_P7.62mm_Horizontal; MPN Yageo MFR-25FBF52-10K
R2, R3: 56; R_Axial_DIN0207_L6.3mm_D2.5mm_P7.62mm_Horizontal; MPN Yageo MFR-25FBF52-56R
R4, R5: 220; R_Axial_DIN0207_L6.3mm_D2.5mm_P7.62mm_Horizontal; MPN Yageo MFR-25FBF52-220R
R6, R7, R9, R10: 1.5k; R_Axial_DIN0207_L6.3mm_D2.5mm_P7.62mm_Horizontal; MPN Yageo MFR-25FBF52-1K5
R8, R11: 3.3k; R_Axial_DIN0207_L6.3mm_D2.5mm_P7.62mm_Horizontal; MPN Yageo MFR-25FBF52-3K3
R12, R13: 360; R_Axial_DIN0207_L6.3mm_D2.5mm_P7.62mm_Horizontal; MPN Yageo MFR-25FBF52-360R
R14, R15: 15; R_Axial_DIN0207_L6.3mm_D2.5mm_P7.62mm_Horizontal; MPN Yageo MFR-25FBF52-15R
R16: 4.7; R_Axial_DIN0207_L6.3mm_D2.5mm_P7.62mm_Horizontal; MPN Yageo MFR-25FBF52-4R7
R17, R18: 3.3; R_Axial_DIN0207_L6.3mm_D2.5mm_P7.62mm_Horizontal; MPN Yageo MFR-25FBF52-3R3
R19, R20, R21, R22: 51; R_Axial_DIN0207_L6.3mm_D2.5mm_P7.62mm_Horizontal; MPN Yageo MFR-25FBF52-51R
R23: 240; R_Axial_DIN0207_L6.3mm_D2.5mm_P7.62mm_Horizontal; MPN Yageo MFR-25FBF52-240R
R24: 1.65k; R_Axial_DIN0207_L6.3mm_D2.5mm_P7.62mm_Horizontal; MPN Yageo MFR-25FBF52-1K65
R25: 1.0; R_Axial_DIN0207_L6.3mm_D2.5mm_P7.62mm_Horizontal; MPN Yageo MFR-25FBF52-1R
TP1: VCC; TestPoint_Keystone_5000-5004_Miniature; MPN Keystone 5000
TP2: X; TestPoint_Keystone_5000-5004_Miniature; MPN Keystone 5000
TP3: OUT; TestPoint_Keystone_5000-5004_Miniature; MPN Keystone 5000
TP4: EF; TestPoint_Keystone_5000-5004_Miniature; MPN Keystone 5000
TP5: EG; TestPoint_Keystone_5000-5004_Miniature; MPN Keystone 5000
TP6: EN; TestPoint_Keystone_5000-5004_Miniature; MPN Keystone 5000
TP7, TP8: GND; TestPoint_Keystone_5000-5004_Miniature; MPN Keystone 5001
U1: LM317T; TO-220-3_Horizontal_TabDown; MPN TI LM317T/NOPB

Connections:
BN: C2.2, Q1.2 (B), R7.2, R8.1
BP: C3.2, Q2.2 (B), R10.2, R11.1
D1: Q5.2 (B), R12.2, R14.2
D2: Q6.2 (B), R13.1, R15.1
DA: D1.1 (K), D2.2 (A)
DB: D3.1 (K), D4.2 (A)
E2A: Q3.1 (E), R14.1
E3A: Q4.1 (E), R15.2
EF: Q5.1 (E), R17.1, TP4.1
EG: Q6.1 (E), R18.1, TP5.1
EN: Q1.1 (E), R2.1, TP6.1
EP: Q2.1 (E), R3.2
FB: C8.1, R4.2
GND: C4.2, C5.2, C6.2, C7.2, C14.2, C16.2, C17.2, C18.2, C19.2, C20.2, C21.2, C22.2, C23.2, C24.2, C25.2, C26.2, D2.1 (K), D3.2 (A), GDT1.3, J1.2, J2.2 (Ext), J3.2 (Ext), J4.2 (Ext), J5.2 (Ext), J6.2, MH1.1, MH2.1, MH3.1, MH4.1, MH5.1, Q3.3 (C), Q6.3 (C), R1.2, R2.2, R5.2, R8.2, R13.2, R24.2, TP7.1, TP8.1
IN: C1.1, GDT1.1, J1.1
J6A: F1.1, J6.1
J6B: D5.2 (A), F1.2
L4B: L4.2, R25.1
LX: C9.2, R5.1
N1: C1.2, C4.1, D1.2 (A), D4.1 (K), L1.1, R1.1
N2: C5.1, L1.2, L2.1
N3: C6.1, L2.2, L3.1
N4: C2.1, C3.1, C7.1, C8.2, L3.2
OUT: C10.1, C11.1, C12.1, C13.1, R17.2, R18.2, TP3.1
P1: J2.1 (In), R19.2
P2: J3.1 (In), R20.2
P3: J4.1 (In), R21.2
P4: J5.1 (In), R22.2
RM: C14.1, R6.2, R7.1
RMP: C15.2, R9.2, R10.1
UADJ: C21.1, D7.2 (A), R23.2, R24.1, U1.1 (ADJ)
UIN: C17.1, C20.1, D5.1 (K), D6.1 (K), U1.3 (VI)
UOUT: C23.1, D6.2 (A), D7.1 (K), L4.1, R23.1, U1.2 (VO)
VCC: C15.1, C18.1, C19.1, C22.1, C24.1, C25.1, C26.1, Q4.3 (C), R3.1, R11.2, R12.1, R16.1, R25.2, TP1.1
VCF: C16.1, Q5.3 (C), R16.2
X: C9.1, Q1.3 (C), Q2.3 (C), Q3.2 (B), Q4.2 (B), R4.1, R6.1, R9.1, TP2.1
XO1: C10.2, R19.1
XO2: C11.2, R20.1
XO3: C12.2, R21.1
XO4: C13.2, R22.1

Notes on the sheet:
INPUT PROTECTION & DC BLOCK
7-POLE LOW-PASS FILTER (L1-L3 VNA-selected to +/-3 %)
COMPLEMENTARY GAIN STAGE - BUILD A (RE1/RE2 56, RF 220, RL 220)
DIAMOND BUFFER (thermal pairs Q3+Q5 and Q4+Q6, flat faces glued)
OUTPUT PORTS
POWER SUPPLY 13.8 V -> +9.8 V (VCC)
TEST POINTS & MOUNTING
PWR_FLAG markers (ERC)
Rev B build A prototype. Net names = sim/scripts/gen.py node names (SimName field = simulation element). Electrical simulation status: see docs/review2-response.md (simulated, not measured). Layout additions vs simulation: C19, C24, C25, C26 extra 100 nF bypass on VCC (ideal rail in simulation); J1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

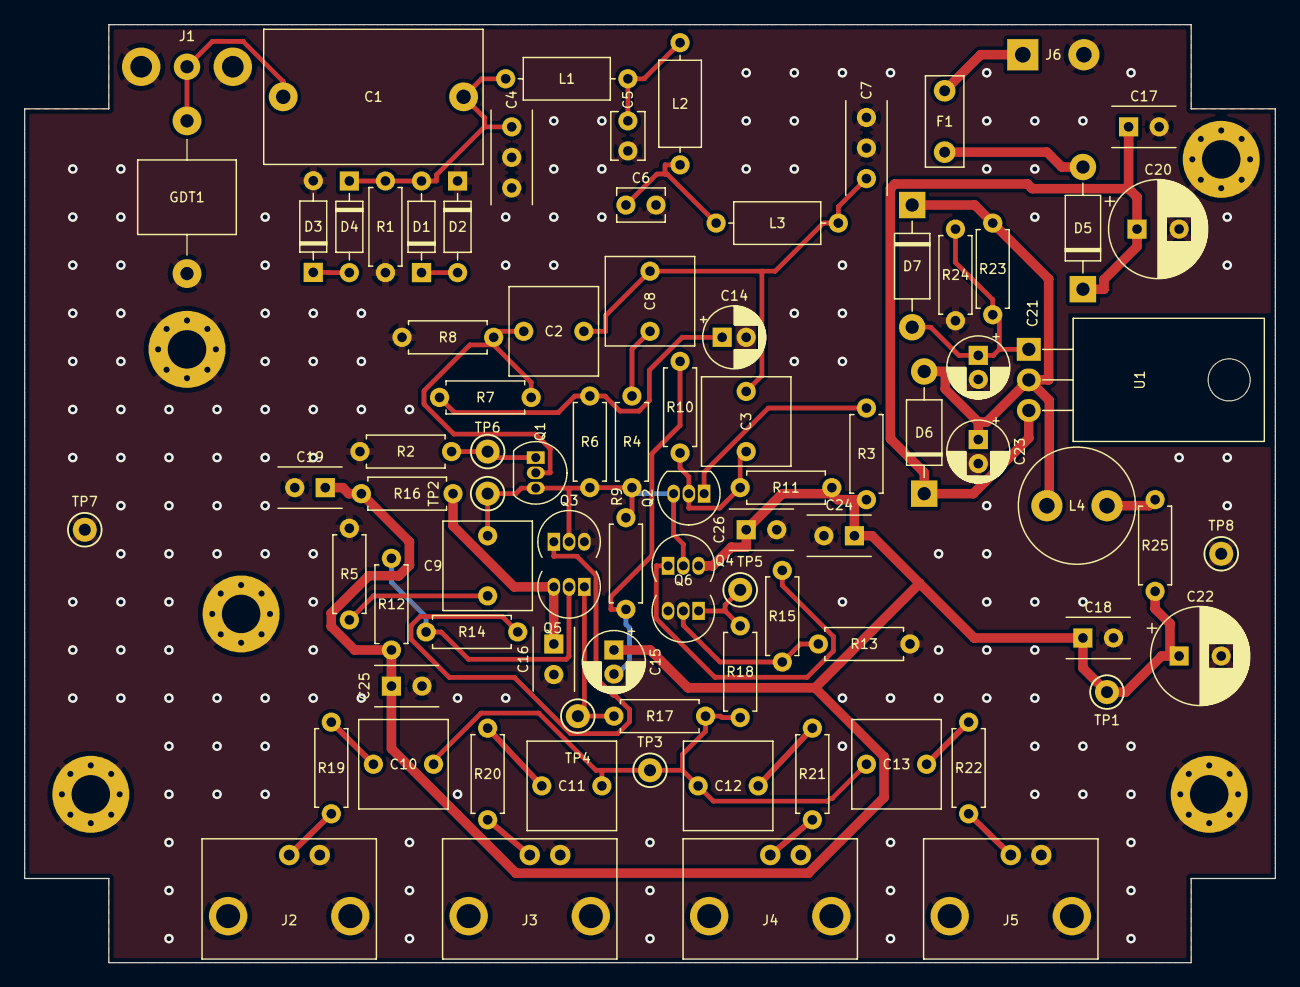
[picture p20: board hfmc.kicad_pcb from above]

Board: 2 copper layers, 104.0 x 78.0 mm, 90 parts (0 on the bottom side), 40 nets.
