K2AAM/HF-Receive-Multicoupler-/(commit log)

2026-11-05 Rev B multicoupler: stocked-parts design, sim package, BOM, review response
    - All transistors 2N3904/2N3906 (Rev A TO-39 RF parts are discontinued)
    - Diamond output buffer for low star impedance at HF
    - 7-pole LPF (36 dB at 88 MHz), 9.9 V rail, film series caps, bias-T removed
    - ngspice testbenches, generator/analysis scripts, Monte Carlo, thermal and
    stability results; bring-up and layout guidance
    Claude-Session: https://claude.ai/code/session_01P4rhENkovRHVZenNKALSuE
    [BOM_revB.csv, ac_revB.csv]
2026-11-06 Rev B review 2: checked sim runner, explicit builds, real tolerances, multiport stability, supply
    - gen.run: per-run temp dir, exit/error/marker/output freshness+completeness checks; 15-check regression harness
    - Builds A/B/C defined explicitly in gen.BUILDS and used by every script, deck, label and doc
    - Independent per-part Monte Carlo with published tolerances; corners for TF, CJC, hFE, rail, temperature
    - LPF: 78FR inductors are +/-10 %; adopt VNA selection to +/-3 % and KEMET C0G +/-2 % (S11 <= -20 dB vs -12 dB unselected)
    - Stability: 5-port S-matrix mu test with sampled reactive terminations to 2 GHz; 33 mixed cable kicks per build plus negative control
    - Supply: RLB0914-100KL L4 + RD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
    [BOM_revB.csv, ac_A.csv, ac_B.csv, ac_C.csv, ac_revB.csv]
2026-11-06 Exact-frequency sampling for all AC metrics; rerun nominal, LPF and Monte Carlo
    - gen.ac_sweep: dense log sweep + exact single-frequency solves at sweep ends, both band edges
    (10 kHz, 50 MHz) and every reported frequency; result frequency checked to 1e-7
    - gen.at: named values only at exactly simulated frequencies (no nearest-point fallback)
    - gen.band_mask/band_extrema: inclusive passband, error if an edge is missing or the band is sparse
    - run_all, mc, lpf_study, supply switched to exact lookups (supply 30 MHz was interpolated)
    - Two-tone records are whole periods of both tones; every product must land on an FFT bin
    - freq_density.py: extrema change <= 0.024 dB from 25 to 400 points/deca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
    [ac_A.csv, ac_B.csv, ac_C.csv]
2026-11-06 C4/C7: stocked +/-5 % 43 pF (C325C430JAG5TA); simulate end-cap tolerance
    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
    [BOM_revB.csv]
2026-11-06 Prototype PCB for build A (KiCad 7, 2-layer THT, Hammond 1590BB)
    - hardware/kicad: native schematic/PCB/project, custom footprint library
    (031-5431-10RFX per Amphenol drawing rev E, thermal-pair TO-92, GDT,
    KEMET C320 / universal C32x, RXEF030), schematic PDF, Gerbers + drill
    (OSH Park zip), BOM with exact MPNs and footprints, board and
    enclosure-fit images, generator and check scripts
    - Signal-path topology unchanged; net names are the gen.py node names and
    every part carries its doc name (DocRef) and simulation element (SimName)
    - Checks: simulation netlist <-> schematic <-> PCB pin-for-pin (PASS),
    scripted ERC (PASS; KiCad GUI ERC still to run), KiCad DRC 0 violations,
    court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
    [BOM_prototype_A.csv, BOM_revB.csv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]
2026-11-06 Build A: retarget the enclosure from Hammond 1590BB to 1590C
    Mechanical adaptation only; circuit, placement and routed copper unchanged.
    - enclosure.py rewritten from the Hammond 1590C drawing and DWG geometry
    (values tagged MFR / DWG / CALC / ASSUME): drafted walls, floor, lid lip,
    screw pillars, notch clearance, stack-up on M3 x 6 brass spacers
    (Wurth 970060354), U1 live-tab clearance, C1 lid clearance (21.5 mm).
    - Insertion-path search: the board cannot go in level (5.5 mm behind it vs
    8.9 mm BNC threads); it goes in tilted about 30 deg, lid off. That needs
    vertical 12.9 x 15.5 mm slots for J2-J5 (threshold 14.4) with an outside
    DIN 433 M12 washer. Milled flat strips inside a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
    [BOM_prototype_A.csv, BOM_revB.csv, hfmc.kicad_pcb, hfmc.kicad_sch]
